spectraphilic/wsn_E5/UiO_LoRa_E5_Mini_logger_v1/E5_logger.pdf

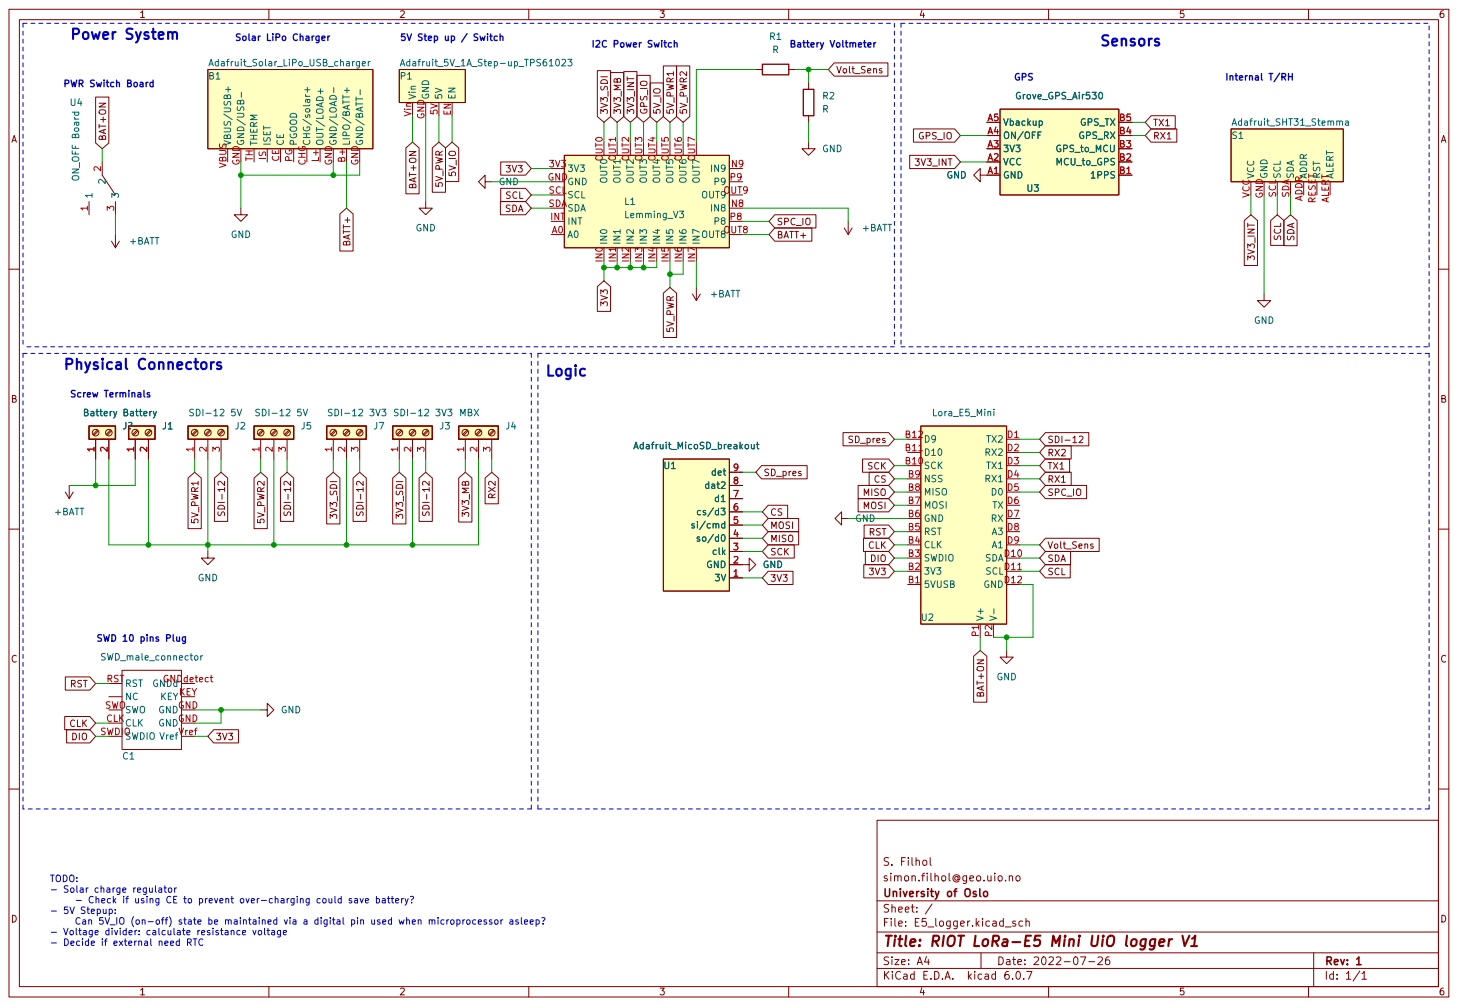
[picture p1: page 1]

Screw Terminals Physical Connectors

simon.filhol@geo.uio.no S. Filhol

TODO: - Solar charge regulator

File: E5_logger.kicad_sch Sheet: / University of Oslo

- Check if using CE to prevent over-charging could save battery?
- 5V Stepup:
Can 5V_IO (on-off) state be maintained via a digital pin used when microprocessor asleep?
- Voltage divider: calculate resistance voltage
- Decide if external need RTC

Id: 1/1 Title: RIOT LoRa-E5 Mini UiO logger V1
