spectraphilic/wsn_E5/(commit log)

2022-07-29 v1 logger initial commit
    [E5_logger.kicad_pcb, E5_logger.kicad_sch]
2022-07-29 added SWD male connector
    [E5_logger.kicad_sch]
2022-07-29 added battery voltage, adjusted UARTs, and SWD connector
    [E5_logger.kicad_sch, Lagopus_v3.kicad_pcb, Lagopus_v3.kicad_sch]
2022-08-01 adjusted details and added backplate cutout
    [E5_logger.kicad_pcb, E5_logger.kicad_sch]
2022-08-01 added schematic plot
2022-08-22 updated to lemmingV3 and sht31
    [E5_logger.kicad_sch]
2022-08-23 added PDF schematic
2022-09-08 changed power pins battery and charger, 3v3
    [E5_logger.kicad_pcb, E5_logger.kicad_sch]
2022-10-26 edited TODOs
    [E5_logger.kicad_sch]
2022-11-10 added RTC
    [E5_logger.kicad_sch]
